jwvdvuurst/6502-board/6502-electrical-draft.csv

Reference | Qty | Value | DNP | Exclude from BOM | Exclude from Board | Exclude from Simulation | Exclude from Position Files | Footprint | Datasheet
C1 | 1 | 100nF - RESET_N power-on delay |  |  |  |  | ${EXCLUDE_FROM_POS_FILES} | Capacitor_THT:C_Disc_D5.0mm_W2.5mm_P5.00mm
C2,C3 | 2 | 27pF - crystal load |  |  |  |  | ${EXCLUDE_FROM_POS_FILES} | Capacitor_THT:C_Disc_D5.0mm_W2.5mm_P5.00mm
C4 | 1 | 100nF - U1 CPU |  |  |  |  | ${EXCLUDE_FROM_POS_FILES} | Capacitor_THT:C_Disc_D5.0mm_W2.5mm_P5.00mm
C5 | 1 | 100nF - U2 VIA |  |  |  |  | ${EXCLUDE_FROM_POS_FILES} | Capacitor_THT:C_Disc_D5.0mm_W2.5mm_P5.00mm
C6 | 1 | 100nF - U3 SRAM |  |  |  |  | ${EXCLUDE_FROM_POS_FILES} | Capacitor_THT:C_Disc_D5.0mm_W2.5mm_P5.00mm
C7 | 1 | 100nF - U4 address decoder |  |  |  |  | ${EXCLUDE_FROM_POS_FILES} | Capacitor_THT:C_Disc_D5.0mm_W2.5mm_P5.00mm
C8 | 1 | 100nF - U5 address mux |  |  |  |  | ${EXCLUDE_FROM_POS_FILES} | Capacitor_THT:C_Disc_D5.0mm_W2.5mm_P5.00mm
C9 | 1 | 100nF - U6 bank data mux |  |  |  |  | ${EXCLUDE_FROM_POS_FILES} | Capacitor_THT:C_Disc_D5.0mm_W2.5mm_P5.00mm
C10 | 1 | 100nF - U7 bank register |  |  |  |  | ${EXCLUDE_FROM_POS_FILES} | Capacitor_THT:C_Disc_D5.0mm_W2.5mm_P5.00mm
C11 | 1 | 100nF - U8 oscillator and inverters |  |  |  |  | ${EXCLUDE_FROM_POS_FILES} | Capacitor_THT:C_Disc_D5.0mm_W2.5mm_P5.00mm
C12 | 1 | 100nF - U9 I/O decoder |  |  |  |  | ${EXCLUDE_FROM_POS_FILES} | Capacitor_THT:C_Disc_D5.0mm_W2.5mm_P5.00mm
C13 | 1 | 100nF - U10 NAND logic |  |  |  |  | ${EXCLUDE_FROM_POS_FILES} | Capacitor_THT:C_Disc_D5.0mm_W2.5mm_P5.00mm
C14 | 1 | 100nF - U12 3-input NAND logic |  |  |  |  | ${EXCLUDE_FROM_POS_FILES} | Capacitor_THT:C_Disc_D5.0mm_W2.5mm_P5.00mm
C15 | 1 | 100nF - U15 NOR logic |  |  |  |  | ${EXCLUDE_FROM_POS_FILES} | Capacitor_THT:C_Disc_D5.0mm_W2.5mm_P5.00mm
C16 | 1 | 100nF - U16 3-input NOR logic |  |  |  |  | ${EXCLUDE_FROM_POS_FILES} | Capacitor_THT:C_Disc_D5.0mm_W2.5mm_P5.00mm
C17 | 1 | 100nF - U18 AND logic |  |  |  |  | ${EXCLUDE_FROM_POS_FILES} | Capacitor_THT:C_Disc_D5.0mm_W2.5mm_P5.00mm
C18 | 1 | 100nF - U19 bus transceiver |  |  |  |  | ${EXCLUDE_FROM_POS_FILES} | Capacitor_THT:C_Disc_D5.0mm_W2.5mm_P5.00mm
C19 | 1 | 100nF - U20 EPROM |  |  |  |  | ${EXCLUDE_FROM_POS_FILES} | Capacitor_THT:C_Disc_D5.0mm_W2.5mm_P5.00mm
C20 | 1 | 100nF - EPROM bypass |  |  |  |  | ${EXCLUDE_FROM_POS_FILES} | Capacitor_THT:C_Disc_D5.0mm_W2.5mm_P5.00mm
C21 | 1 | 10uF - 3V3 bulk bypass |  |  |  |  | ${EXCLUDE_FROM_POS_FILES} | Capacitor_THT:C_Disc_D5.0mm_W2.5mm_P5.00mm
J1 | 1 | REGULATED +3V3 INPUT - no regulator on board |  |  |  |  | ${EXCLUDE_FROM_POS_FILES} | Connector_PinHeader_2.54mm:PinHeader_1x02_P2.54mm_Vertical
J2 | 1 | Pico external harness - do not power Pico from this header |  |  |  |  | ${EXCLUDE_FROM_POS_FILES} | Connector_PinHeader_2.54mm:PinHeader_1x14_P2.54mm_Vertical
R1 | 1 | 1M - HCU04 crystal feedback |  |  |  |  | ${EXCLUDE_FROM_POS_FILES} | Resistor_THT:R_Axial_DIN0207_L6.3mm_D2.5mm_P7.62mm_Horizontal
R2 | 1 | 1k - crystal drive limiter |  |  |  |  | ${EXCLUDE_FROM_POS_FILES} | Resistor_THT:R_Axial_DIN0207_L6.3mm_D2.5mm_P7.62mm_Horizontal
R3 | 1 | 10k - RDY_N pull-up |  |  |  |  | ${EXCLUDE_FROM_POS_FILES} | Resistor_THT:R_Axial_DIN0207_L6.3mm_D2.5mm_P7.62mm_Horizontal
R4 | 1 | 10k - NMI_N pull-up |  |  |  |  | ${EXCLUDE_FROM_POS_FILES} | Resistor_THT:R_Axial_DIN0207_L6.3mm_D2.5mm_P7.62mm_Horizontal
R5 | 1 | 10k - BE pull-up |  |  |  |  | ${EXCLUDE_FROM_POS_FILES} | Resistor_THT:R_Axial_DIN0207_L6.3mm_D2.5mm_P7.62mm_Horizontal
R6 | 1 | 10k - SO_N pull-up |  |  |  |  | ${EXCLUDE_FROM_POS_FILES} | Resistor_THT:R_Axial_DIN0207_L6.3mm_D2.5mm_P7.62mm_Horizontal
R7 | 1 | 10k - RESET_N pull-up |  |  |  |  | ${EXCLUDE_FROM_POS_FILES} | Resistor_THT:R_Axial_DIN0207_L6.3mm_D2.5mm_P7.62mm_Horizontal
R8 | 1 | 10k - IRQ_N pull-up |  |  |  |  | ${EXCLUDE_FROM_POS_FILES} | Resistor_THT:R_Axial_DIN0207_L6.3mm_D2.5mm_P7.62mm_Horizontal
R9 | 1 | 10k - BUS_OE_N reset pull-up |  |  |  |  | ${EXCLUDE_FROM_POS_FILES} | Resistor_THT:R_Axial_DIN0207_L6.3mm_D2.5mm_P7.62mm_Horizontal
R10 | 1 | 10k - BUS_REQ reset pull-down |  |  |  |  | ${EXCLUDE_FROM_POS_FILES} | Resistor_THT:R_Axial_DIN0207_L6.3mm_D2.5mm_P7.62mm_Horizontal
R11 | 1 | 10k - BUS_DIR reset pull-down |  |  |  |  | ${EXCLUDE_FROM_POS_FILES} | Resistor_THT:R_Axial_DIN0207_L6.3mm_D2.5mm_P7.62mm_Horizontal
R12 | 1 | 10k - BUS_ACK idle pull-down |  |  |  |  | ${EXCLUDE_FROM_POS_FILES} | Resistor_THT:R_Axial_DIN0207_L6.3mm_D2.5mm_P7.62mm_Horizontal
SW1 | 1 | RESET |  |  |  |  | ${EXCLUDE_FROM_POS_FILES} | Button_Switch_THT:SW_PUSH_6mm
U1 | 1 | W65C02S6TPG-14 |  |  |  |  | ${EXCLUDE_FROM_POS_FILES} | Package_DIP:DIP-40_W15.24mm_Socket | https://www.westerndesigncenter.com/wdc/documentation/w65c02s.pdf
U2 | 1 | W65C22S6TPG-14 |  |  |  |  | ${EXCLUDE_FROM_POS_FILES} | Package_DIP:DIP-40_W15.24mm_Socket | https://www.westerndesigncenter.com/wdc/documentation/w65c22.pdf
U3 | 1 | AS6C4008 (512K x 8; use lower 256K) |  |  |  |  | ${EXCLUDE_FROM_POS_FILES} | Package_DIP:DIP-32_W15.24mm_Socket | https://www.alliancememory.com/wp-content/uploads/pdf/AS6C4008.pdf
U4 | 1 | 74HC138 |  |  |  |  | ${EXCLUDE_FROM_POS_FILES} | Package_DIP:DIP-16_W7.62mm_Socket | https://www.ti.com/lit/ds/symlink/sn74hc138.pdf
U5 | 1 | 74HC157 - SRAM address mux |  |  |  |  | ${EXCLUDE_FROM_POS_FILES} | Package_DIP:DIP-16_W7.62mm_Socket | https://www.ti.com/lit/ds/symlink/sn74hc157.pdf
U6 | 1 | 74HC157 - bank write data mux |  |  |  |  | ${EXCLUDE_FROM_POS_FILES} | Package_DIP:DIP-16_W7.62mm_Socket | https://www.ti.com/lit/ds/symlink/sn74hc157.pdf
U7 | 1 | 74HC273 - bank register |  |  |  |  | ${EXCLUDE_FROM_POS_FILES} | Package_DIP:DIP-20_W7.62mm_Socket | https://www.ti.com/lit/ds/symlink/sn74hc273.pdf
U8 | 1 | 74HCU04 |  |  |  |  | ${EXCLUDE_FROM_POS_FILES} | Package_DIP:DIP-14_W7.62mm_Socket | https://www.ti.com/lit/ds/symlink/sn74hcu04.pdf
U9 | 1 | 74HC138 - low-address I/O decode |  |  |  |  | ${EXCLUDE_FROM_POS_FILES} | Package_DIP:DIP-16_W7.62mm_Socket | https://www.ti.com/lit/ds/symlink/sn74hc138.pdf
U10 | 1 | 74HC00 |  |  |  |  | ${EXCLUDE_FROM_POS_FILES} | Package_DIP:DIP-14_W7.62mm_Socket | https://www.ti.com/lit/ds/symlink/sn74hc00.pdf
U12 | 1 | 74HC10 |  |  |  |  | ${EXCLUDE_FROM_POS_FILES} | Package_DIP:DIP-14_W7.62mm_Socket | https://www.ti.com/lit/ds/symlink/sn74hc10.pdf
U15 | 1 | 74HC02 |  |  |  |  | ${EXCLUDE_FROM_POS_FILES} | Package_DIP:DIP-14_W7.62mm_Socket | https://www.ti.com/lit/ds/symlink/sn74hc02.pdf
U16 | 1 | 74HC27 |  |  |  |  | ${EXCLUDE_FROM_POS_FILES} | Package_DIP:DIP-14_W7.62mm_Socket | https://www.ti.com/lit/ds/symlink/sn74hc27.pdf
U18 | 1 | 74HC08 |  |  |  |  | ${EXCLUDE_FROM_POS_FILES} | Package_DIP:DIP-14_W7.62mm_Socket | https://www.ti.com/lit/ds/symlink/sn74hc08.pdf
U19 | 1 | SN74HC245N - Pico/VIA bus transceiver |  |  |  |  | ${EXCLUDE_FROM_POS_FILES} | Package_DIP:DIP-20_W7.62mm_Socket | https://www.ti.com/lit/ds/symlink/sn74hc245.pdf
U20 | 1 | AT27LV256A 3.3V OTP EPROM - legacy DIP variant; verify sourcing |  |  |  |  | ${EXCLUDE_FROM_POS_FILES} | Package_DIP:DIP-28_W15.24mm_Socket | https://ww1.microchip.com/downloads/en/DeviceDoc/doc0601.pdf
Y1 | 1 | 1.000MHz fundamental, CL=16pF |  |  |  |  | ${EXCLUDE_FROM_POS_FILES} | Crystal:Crystal_HC49-U_Vertical
