jwvdvuurst/6502-board/6502-board-architecture.pdf

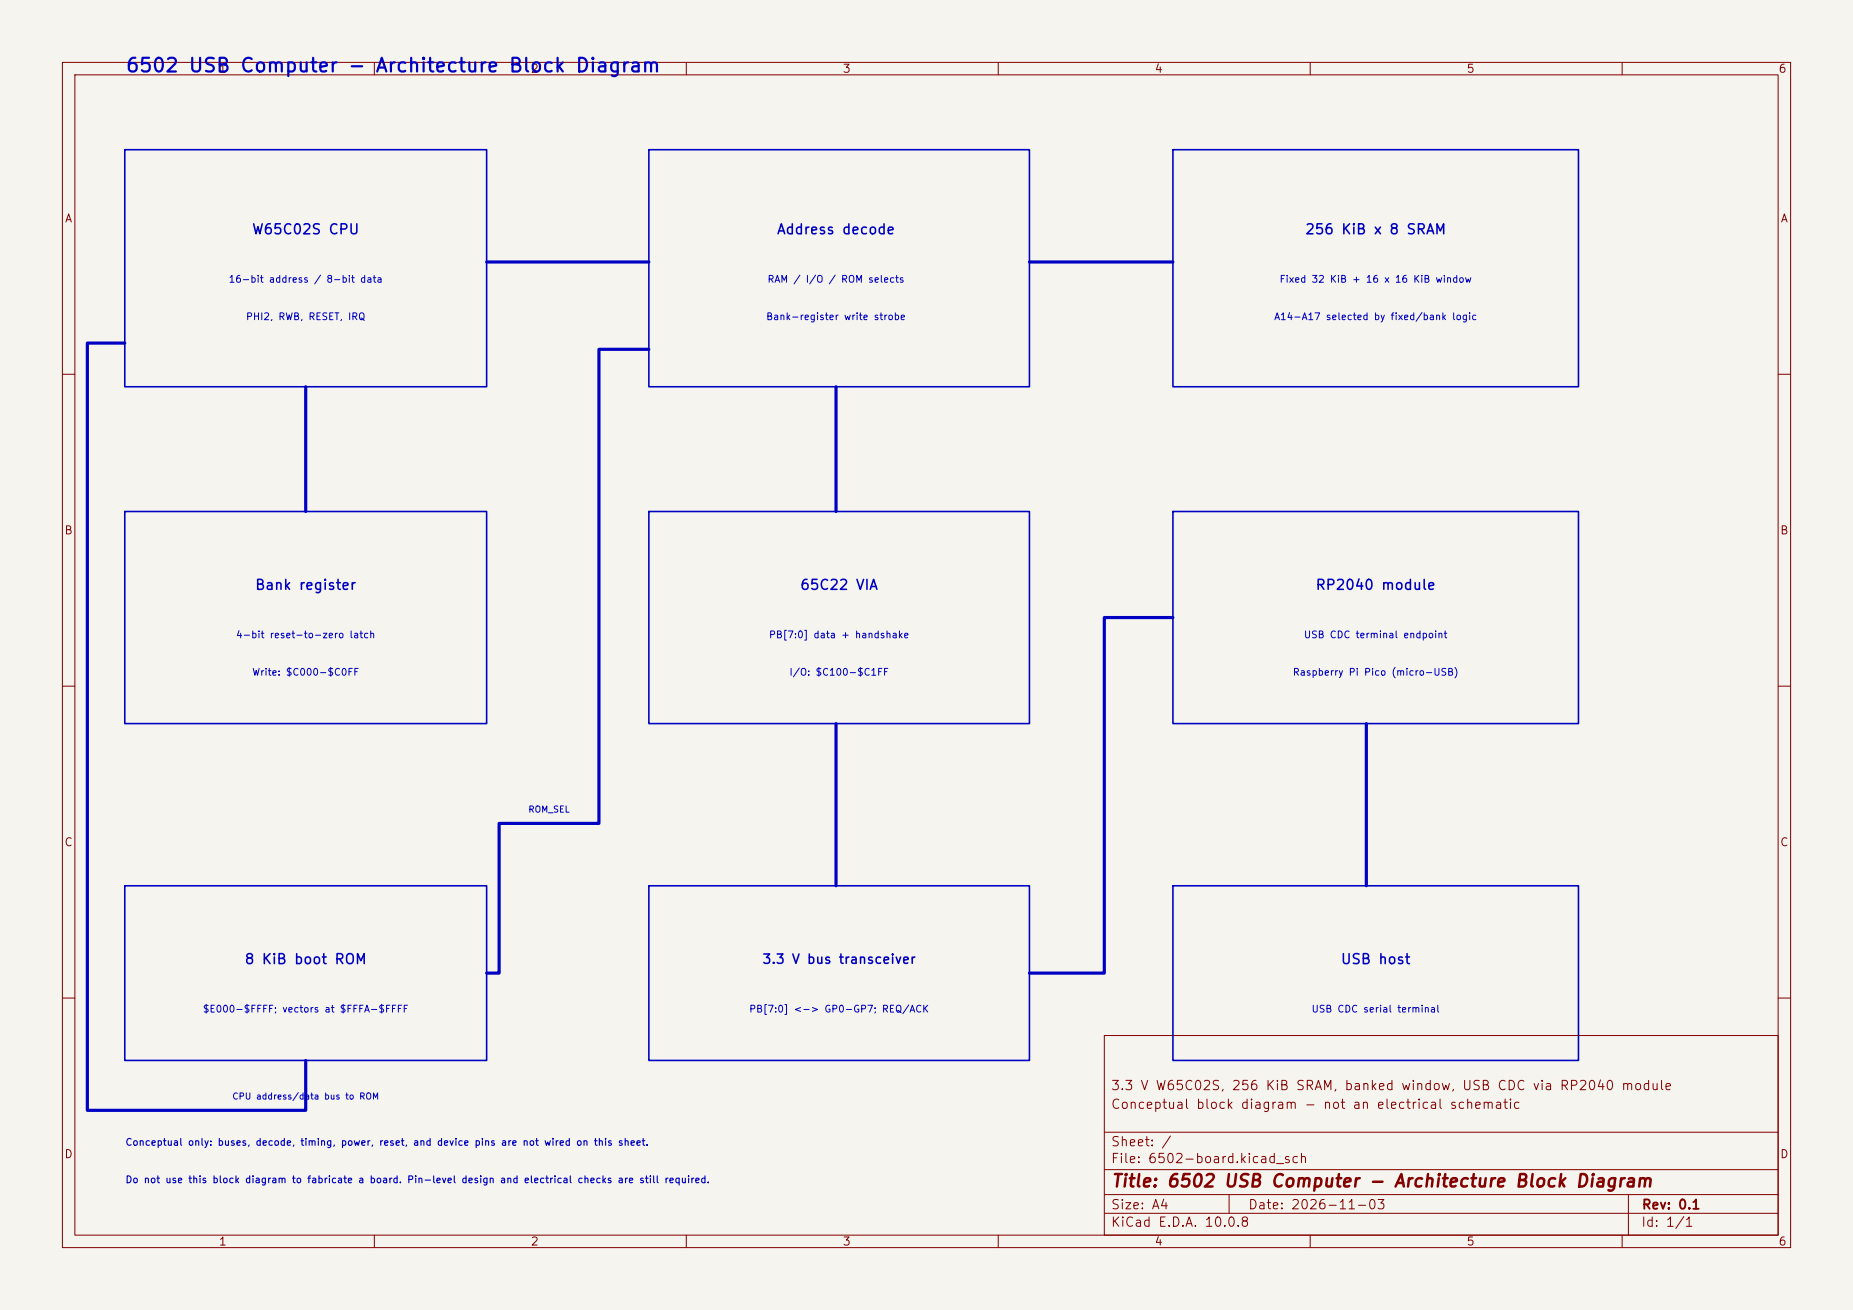
[picture p1: page 1]

16-bit address / 8-bit data

A14-A17 selected by fixed/bank logic

Raspberry Pi Pico (micro-USB)

$E000-$FFFF; vectors at $FFFA-$FFFF CPU address/data bus to ROM

3.3 V W65C02S, 256 KiB SRAM, banked window, USB CDC via RP2040 module
Conceptual block diagram - not an electrical schematic

Conceptual only: buses, decode, timing, power, reset, and device pins are not wired on this sheet.

Sheet: /
File: 6502-board.kicad_sch
Title: 6502 USB Computer - Architecture Block Diagram

Do not use this block diagram to fabricate a board. Pin-level design and electrical checks are still required.

Size: A4 | Rev: 0.1
KiCad E.D.A. 10.0.8 | Id: 1/1
