jwvdvuurst/6502-board/6502-electrical-draft.kicad_pcb

## KiCad design 6502-electrical-draft.kicad_pcb (2026-11-06)

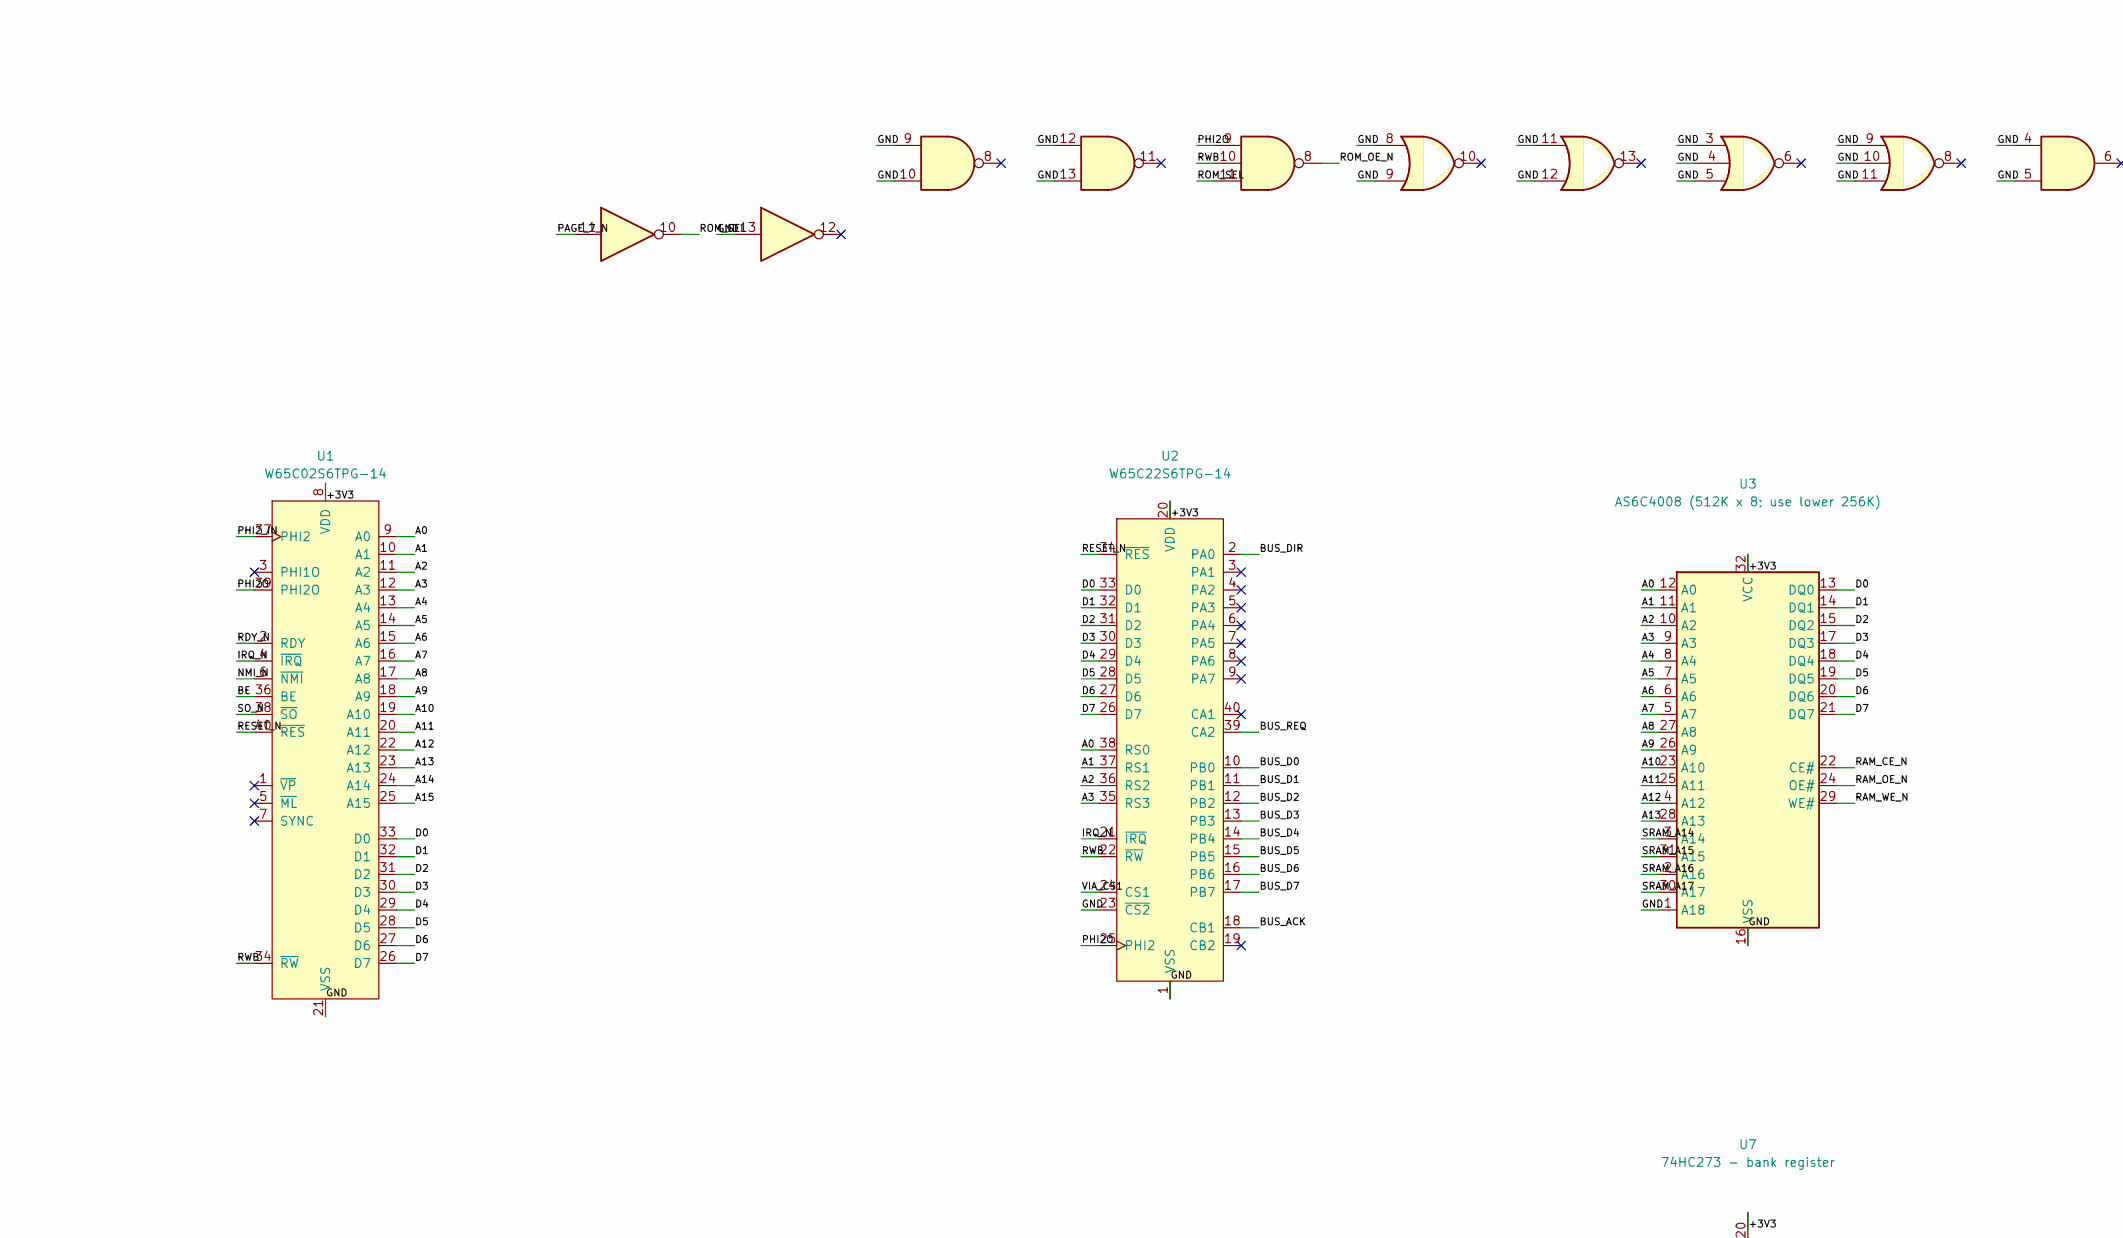
[picture p3: schematic 6502-electrical-draft.kicad_sch, 6502 Electrical Draft - CPU, VIA, SRAM and EPROM, part in row 1, column 1]

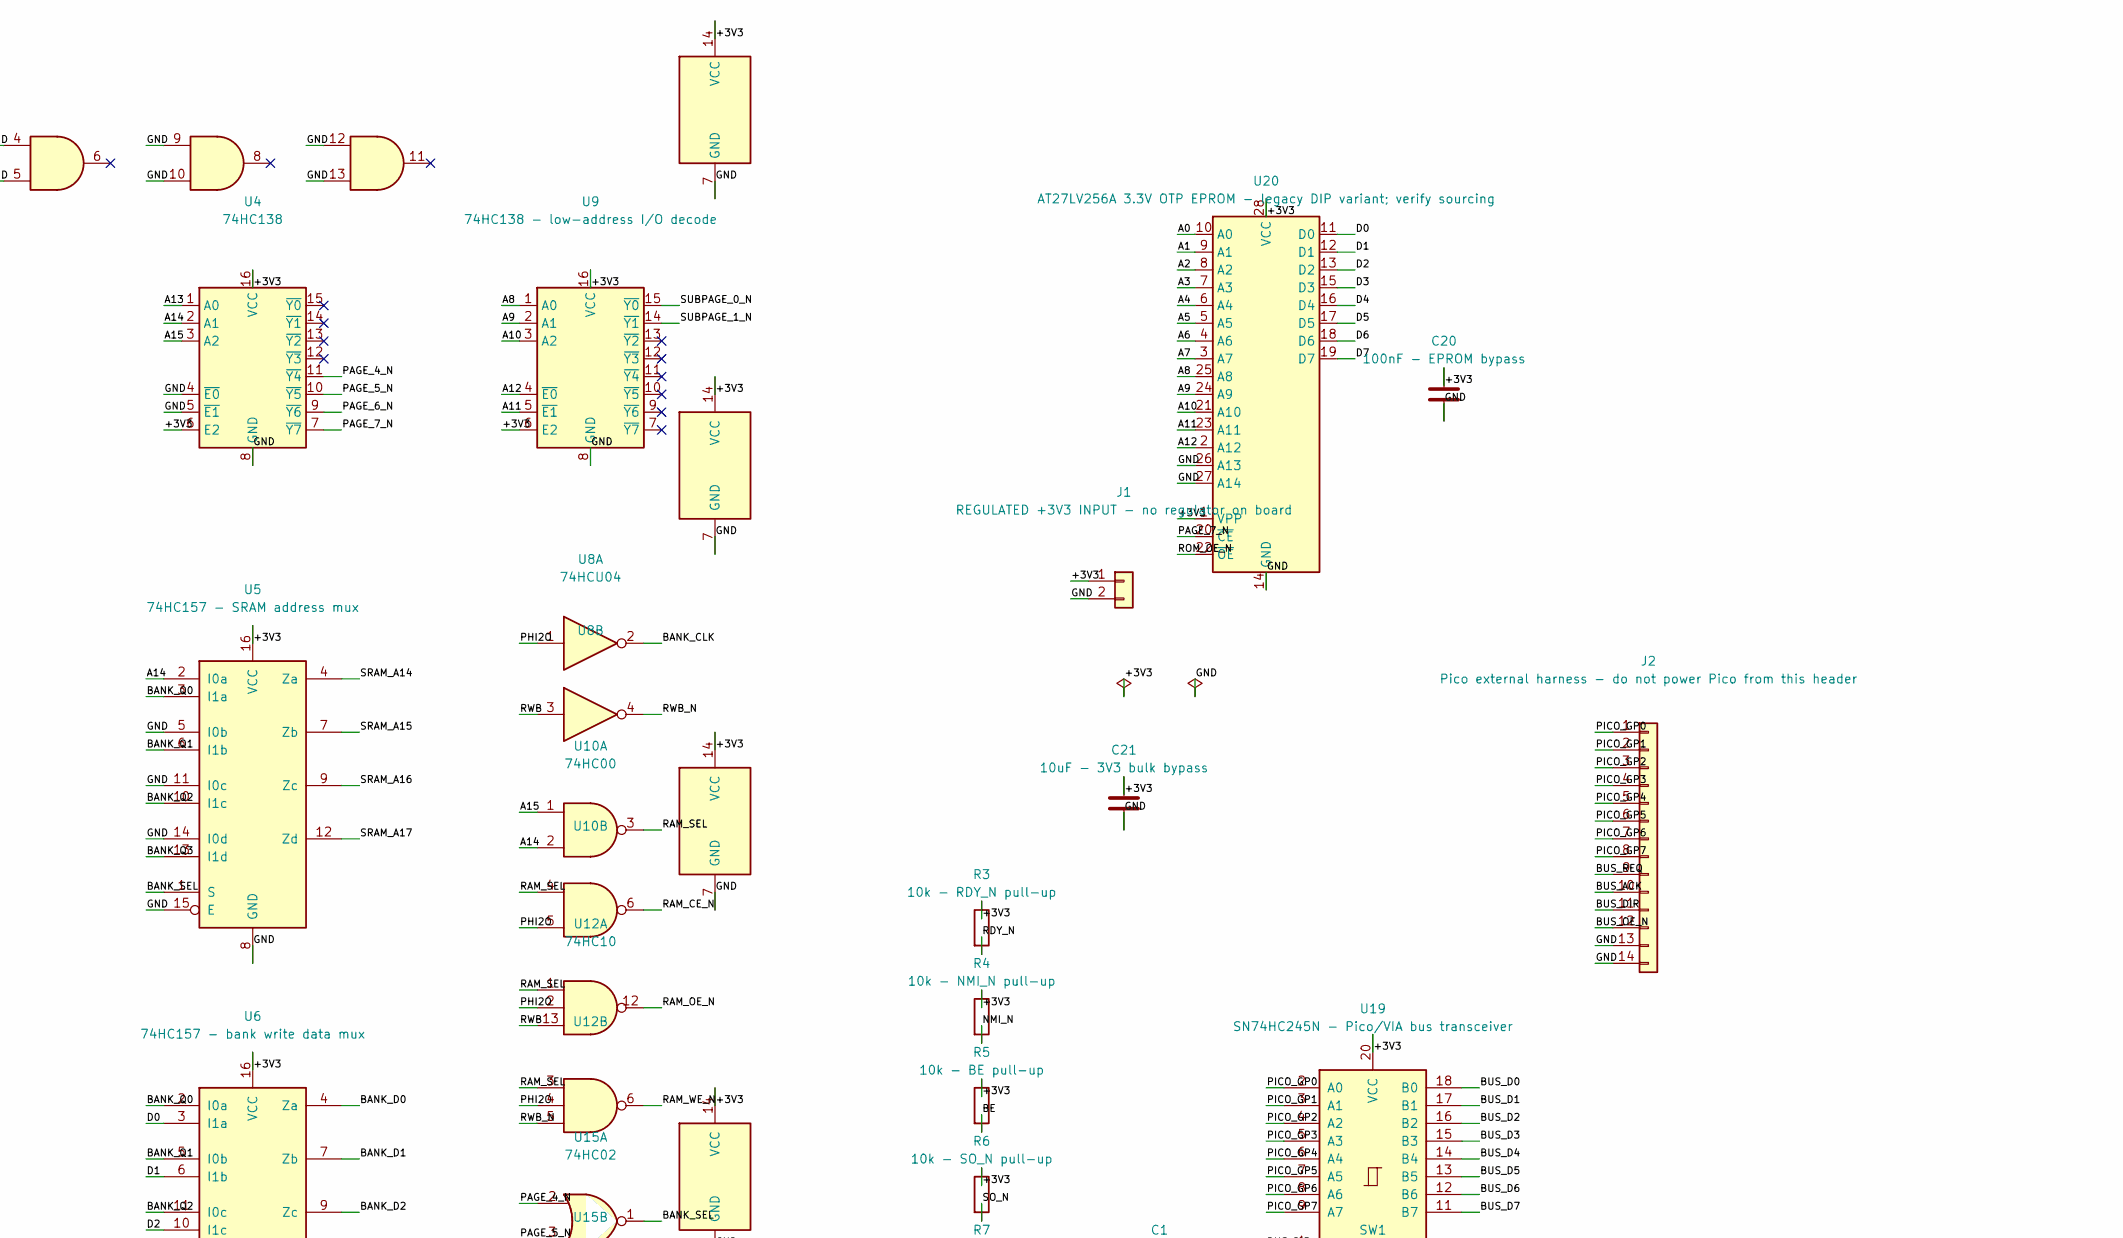
[picture p4: schematic 6502-electrical-draft.kicad_sch, 6502 Electrical Draft - CPU, VIA, SRAM and EPROM, part in row 1, column 2]

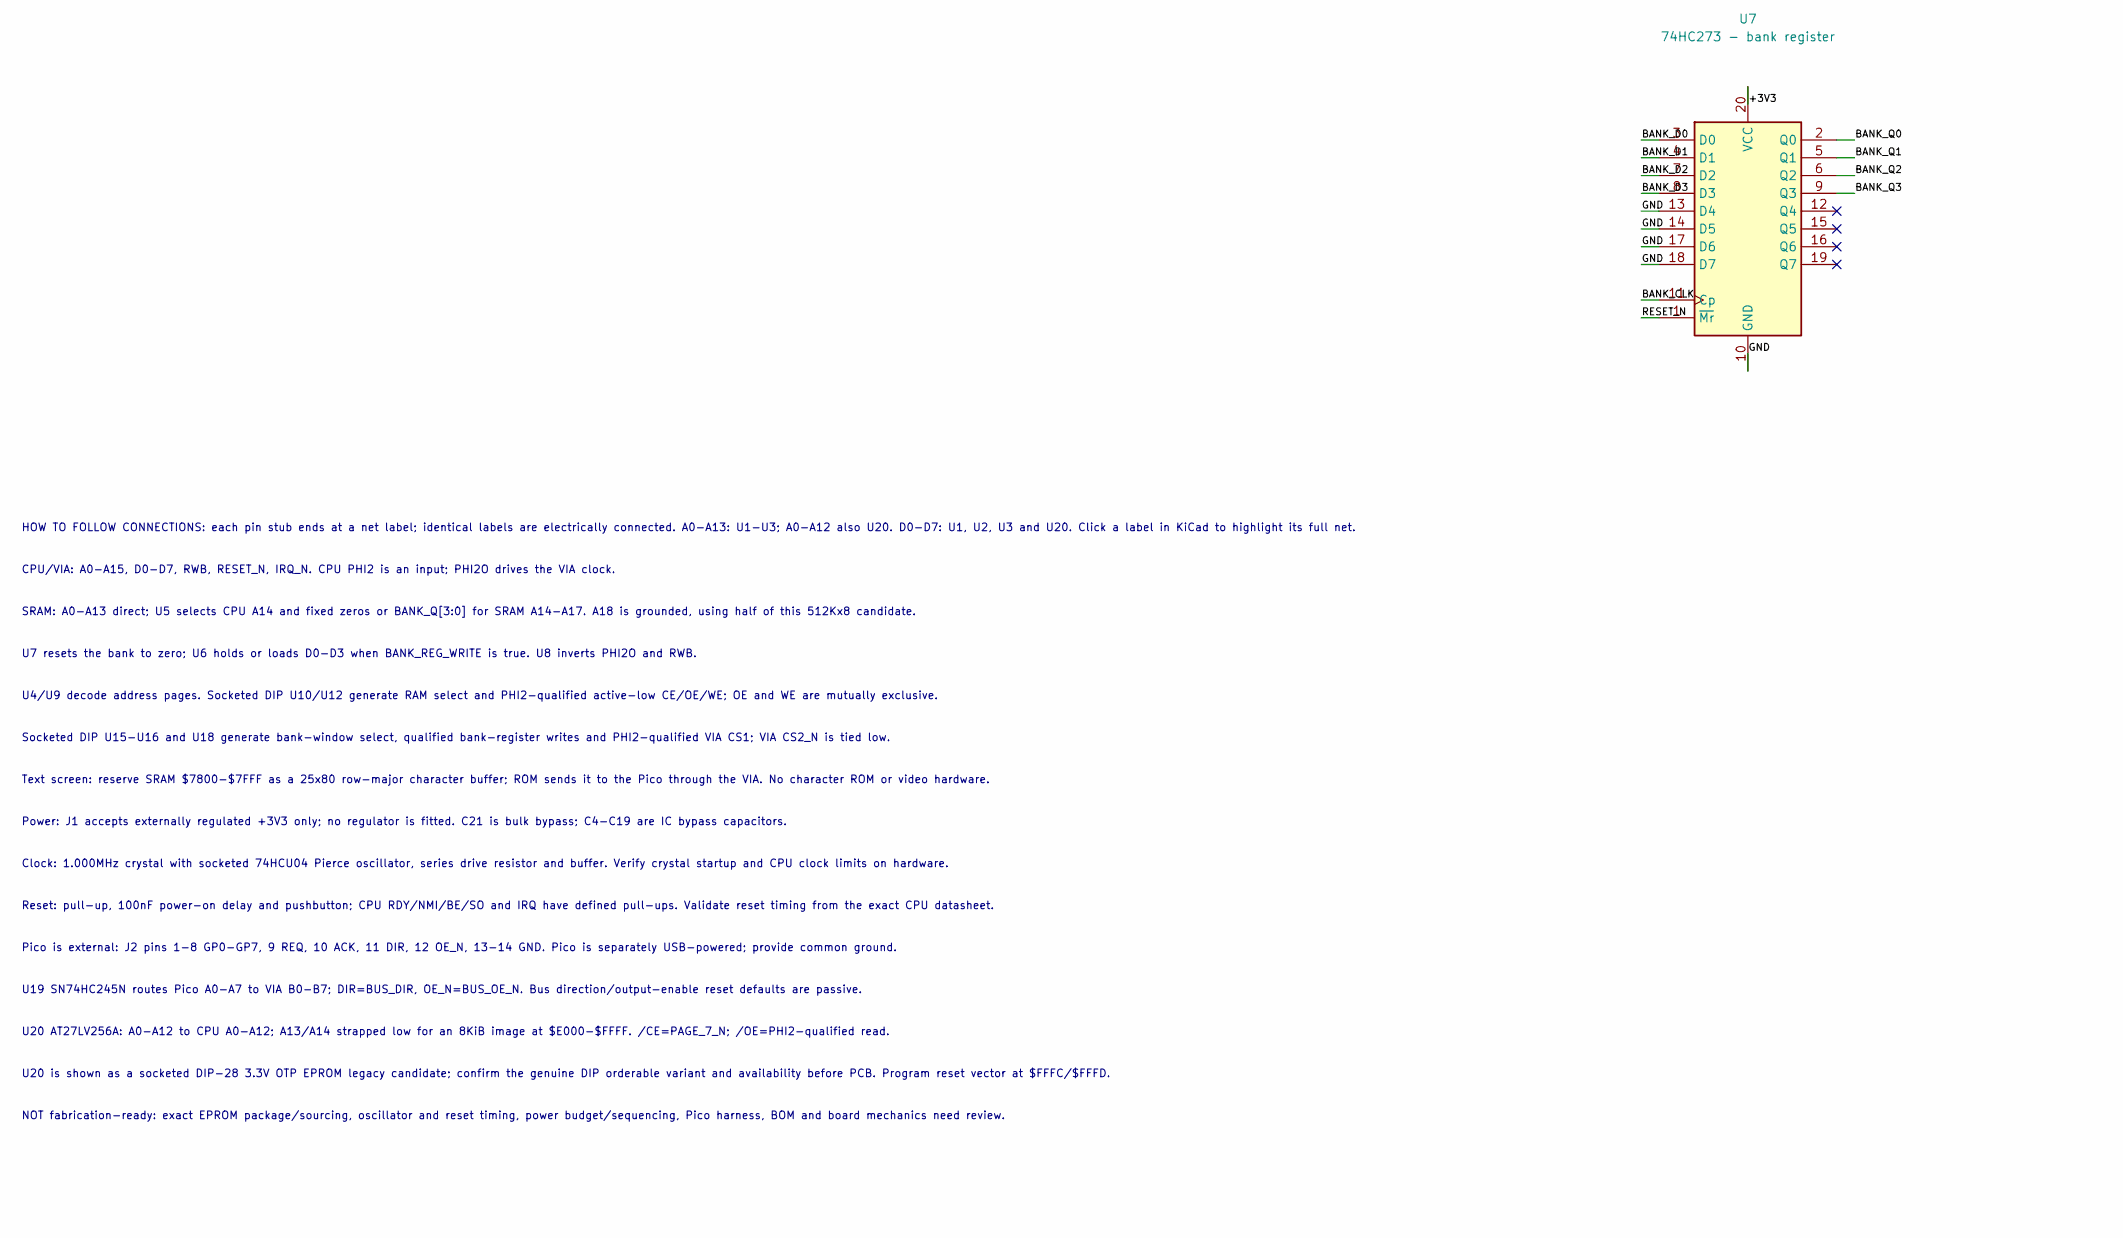
[picture p5: schematic 6502-electrical-draft.kicad_sch, 6502 Electrical Draft - CPU, VIA, SRAM and EPROM, part in row 2, column 1]

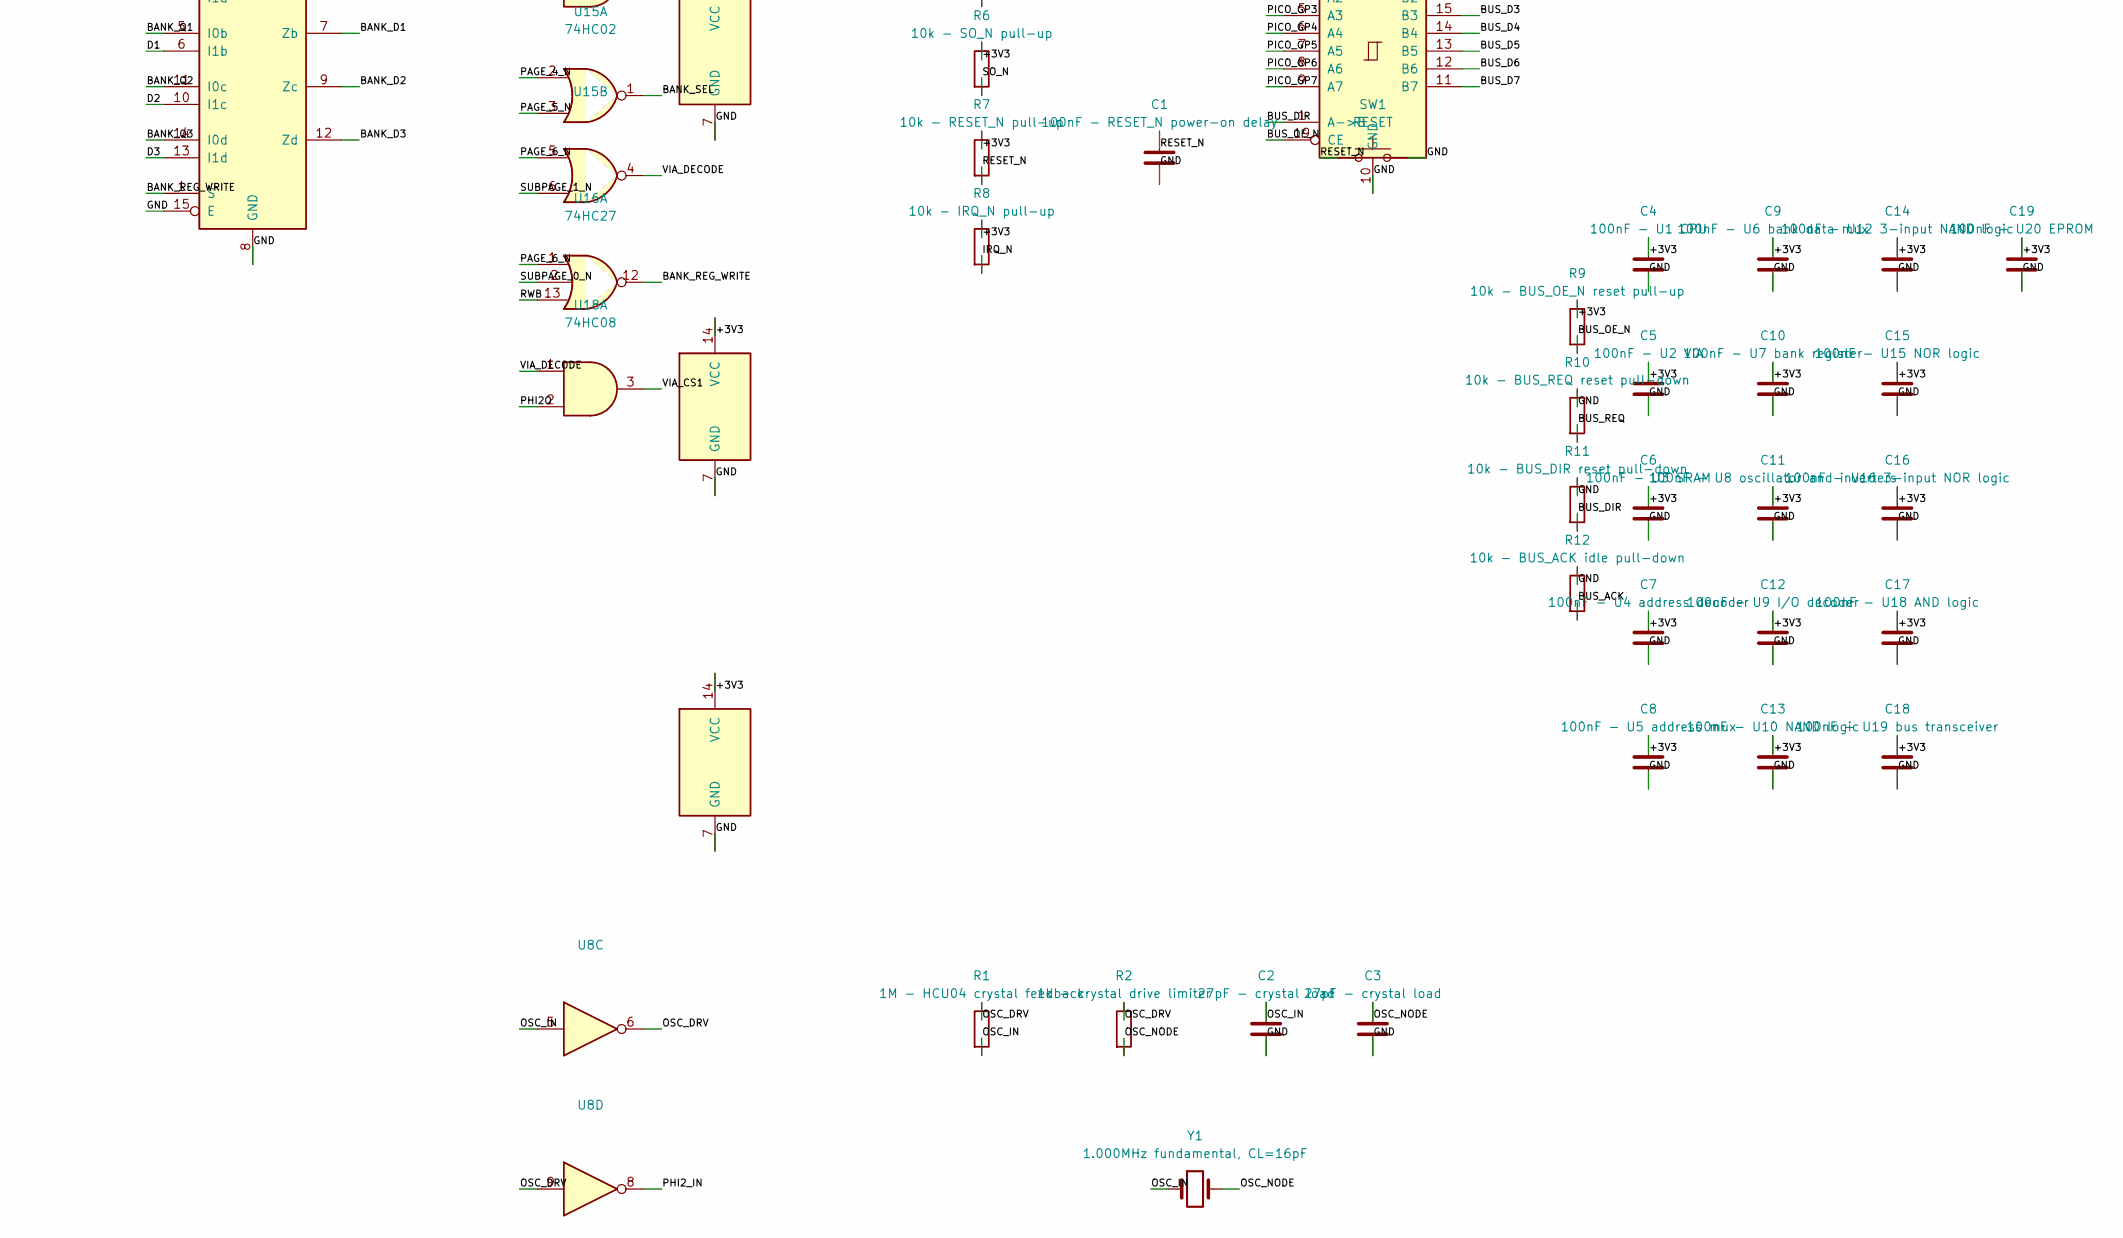
[picture p6: schematic 6502-electrical-draft.kicad_sch, 6502 Electrical Draft - CPU, VIA, SRAM and EPROM, part in row 2, column 2]

Parts:
C1: 100nF - RESET_N power-on delay; C_Disc_D5.0mm_W2.5mm_P5.00mm
C2, C3: 27pF - crystal load; C_Disc_D5.0mm_W2.5mm_P5.00mm
C4: 100nF - U1 CPU; C_Disc_D5.0mm_W2.5mm_P5.00mm
C5: 100nF - U2 VIA; C_Disc_D5.0mm_W2.5mm_P5.00mm
C6: 100nF - U3 SRAM; C_Disc_D5.0mm_W2.5mm_P5.00mm
C7: 100nF - U4 address decoder; C_Disc_D5.0mm_W2.5mm_P5.00mm
C8: 100nF - U5 address mux; C_Disc_D5.0mm_W2.5mm_P5.00mm
C9: 100nF - U6 bank data mux; C_Disc_D5.0mm_W2.5mm_P5.00mm
C10: 100nF - U7 bank register; C_Disc_D5.0mm_W2.5mm_P5.00mm
C11: 100nF - U8 oscillator and inverters; C_Disc_D5.0mm_W2.5mm_P5.00mm
C12: 100nF - U9 I/O decoder; C_Disc_D5.0mm_W2.5mm_P5.00mm
C13: 100nF - U10 NAND logic; C_Disc_D5.0mm_W2.5mm_P5.00mm
C14: 100nF - U12 3-input NAND logic; C_Disc_D5.0mm_W2.5mm_P5.00mm
C15: 100nF - U15 NOR logic; C_Disc_D5.0mm_W2.5mm_P5.00mm
C16: 100nF - U16 3-input NOR logic; C_Disc_D5.0mm_W2.5mm_P5.00mm
C17: 100nF - U18 AND logic; C_Disc_D5.0mm_W2.5mm_P5.00mm
C18: 100nF - U19 bus transceiver; C_Disc_D5.0mm_W2.5mm_P5.00mm
C19: 100nF - U20 EPROM; C_Disc_D5.0mm_W2.5mm_P5.00mm
C20: 100nF - EPROM bypass; C_Disc_D5.0mm_W2.5mm_P5.00mm
C21: 10uF - 3V3 bulk bypass; C_Disc_D5.0mm_W2.5mm_P5.00mm
J1: REGULATED +3V3 INPUT - no regulator on board; PinHeader_1x02_P2.54mm_Vertical
J2: Pico external harness - do not power Pico from th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; PinHeader_1x14_P2.54mm_Vertical
R1: 1M - HCU04 crystal feedback; R_Axial_DIN0207_L6.3mm_D2.5mm_P7.62mm_Horizontal
R2: 1k - crystal drive limiter; R_Axial_DIN0207_L6.3mm_D2.5mm_P7.62mm_Horizontal
R3: 10k - RDY_N pull-up; R_Axial_DIN0207_L6.3mm_D2.5mm_P7.62mm_Horizontal
R4: 10k - NMI_N pull-up; R_Axial_DIN0207_L6.3mm_D2.5mm_P7.62mm_Horizontal
R5: 10k - BE pull-up; R_Axial_DIN0207_L6.3mm_D2.5mm_P7.62mm_Horizontal
R6: 10k - SO_N pull-up; R_Axial_DIN0207_L6.3mm_D2.5mm_P7.62mm_Horizontal
R7: 10k - RESET_N pull-up; R_Axial_DIN0207_L6.3mm_D2.5mm_P7.62mm_Horizontal
R8: 10k - IRQ_N pull-up; R_Axial_DIN0207_L6.3mm_D2.5mm_P7.62mm_Horizontal
R9: 10k - BUS_OE_N reset pull-up; R_Axial_DIN0207_L6.3mm_D2.5mm_P7.62mm_Horizontal
R10: 10k - BUS_REQ reset pull-down; R_Axial_DIN0207_L6.3mm_D2.5mm_P7.62mm_Horizontal
R11: 10k - BUS_DIR reset pull-down; R_Axial_DIN0207_L6.3mm_D2.5mm_P7.62mm_Horizontal
R12: 10k - BUS_ACK idle pull-down; R_Axial_DIN0207_L6.3mm_D2.5mm_P7.62mm_Horizontal
SW1: RESET; SW_PUSH_6mm
U1: W65C02S6TPG-14; DIP-40_W15.24mm_Socket
U2: W65C22S6TPG-14; DIP-40_W15.24mm_Socket
U3: AS6C4008 (512K x 8; use lower 256K); DIP-32_W15.24mm_Socket
U4: 74HC138; DIP-16_W7.62mm_Socket
U5: 74HC157 - SRAM address mux; DIP-16_W7.62mm_Socket
U6: 74HC157 - bank write data mux; DIP-16_W7.62mm_Socket
U7: 74HC273 - bank register; DIP-20_W7.62mm_Socket
U8: 74HCU04; DIP-14_W7.62mm_Socket
U9: 74HC138 - low-address I/O decode; DIP-16_W7.62mm_Socket
U10: 74HC00; DIP-14_W7.62mm_Socket
U12: 74HC10; DIP-14_W7.62mm_Socket
U15: 74HC02; DIP-14_W7.62mm_Socket
U16: 74HC27; DIP-14_W7.62mm_Socket
U18: 74HC08; DIP-14_W7.62mm_Socket
U19: SN74HC245N - Pico/VIA bus transceiver; DIP-20_W7.62mm_Socket
U20: AT27LV256A 3.3V OTP EPROM - legacy DIP variant; v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; DIP-28_W15.24mm_Socket
Y1: 1.000MHz fundamental, CL=16pF; Crystal_HC49-U_Vertical

Connections:
/+3V3: C4.1, C5.1, C6.1, C7.1, C8.1, C9.1, C10.1, C11.1, C12.1, C13.1, C14.1, C15.1, C16.1, C17.1, C18.1, C19.1, C20.1, C21.1, J1.1, R3.1, R4.1, R5.1, R6.1, R7.1, R8.1, R9.1, U1.8 (VDD), U2.20 (VDD), U3.32 (VCC), U4.6 (E2), U4.16 (VCC), U5.16 (VCC), U6.16 (VCC), U7.20 (VCC), U8.14 (VCC), U9.6 (E2), U9.16 (VCC), U10.14 (VCC), U12.14 (VCC), U15.14 (VCC), U16.14 (VCC), U18.14 (VCC), U19.20 (VCC), U20.1 (VPP), U20.28 (VCC)
/A0: U1.9 (A0), U2.38 (RS0), U3.12 (A0), U20.10 (A0)
/A1: U1.10 (A1), U2.37 (RS1), U3.11 (A1), U20.9 (A1)
/A2: U1.11 (A2), U2.36 (RS2), U3.10 (A2), U20.8 (A2)
/A3: U1.12 (A3), U2.35 (RS3), U3.9 (A3), U20.7 (A3)
/A4: U1.13 (A4), U3.8 (A4), U20.6 (A4)
/A5: U1.14 (A5), U3.7 (A5), U20.5 (A5)
/A6: U1.15 (A6), U3.6 (A6), U20.4 (A6)
/A7: U1.16 (A7), U3.5 (A7), U20.3 (A7)
/A8: U1.17 (A8), U3.27 (A8), U9.1 (A0), U20.25 (A8)
/A9: U1.18 (A9), U3.26 (A9), U9.2 (A1), U20.24 (A9)
/A10: U1.19 (A10), U3.23 (A10), U9.3 (A2), U20.21 (A10)
/A11: U1.20 (A11), U3.25 (A11), U9.5 (~E1), U20.23 (A11)
/A12: U1.22 (A12), U3.4 (A12), U9.4 (~E0), U20.2 (A12)
/A13: U1.23 (A13), U3.28 (A13), U4.1 (A0)
/A14: U1.24 (A14), U4.2 (A1), U5.2 (I0a), U10.2
/A15: U1.25 (A15), U4.3 (A2), U10.1
/BANK_CLK: U7.11 (Cp), U8.2
/BANK_D0: U6.4 (Za), U7.3 (D0)
/BANK_D1: U6.7 (Zb), U7.4 (D1)
/BANK_D2: U6.9 (Zc), U7.7 (D2)
/BANK_D3: U6.12 (Zd), U7.8 (D3)
/BANK_Q0: U5.3 (I1a), U6.2 (I0a), U7.2 (Q0)
/BANK_Q1: U5.6 (I1b), U6.5 (I0b), U7.5 (Q1)
/BANK_Q2: U5.10 (I1c), U6.11 (I0c), U7.6 (Q2)
/BANK_Q3: U5.13 (I1d), U6.14 (I0d), U7.9 (Q3)
/BANK_REG_WRITE: U6.1 (S), U16.12
/BANK_SEL: U5.1 (S), U15.1
/BE: R5.2, U1.36 (BE)
/BUS_ACK: J2.10, R12.2, U2.18 (CB1)
/BUS_D0: U2.10 (PB0), U19.18 (B0)
/BUS_D1: U2.11 (PB1), U19.17 (B1)
/BUS_D2: U2.12 (PB2), U19.16 (B2)
/BUS_D3: U2.13 (PB3), U19.15 (B3)
/BUS_D4: U2.14 (PB4), U19.14 (B4)
/BUS_D5: U2.15 (PB5), U19.13 (B5)
/BUS_D6: U2.16 (PB6), U19.12 (B6)
/BUS_D7: U2.17 (PB7), U19.11 (B7)
/BUS_DIR: J2.11, R11.2, U2.2 (PA0), U19.1 (A->B)
/BUS_OE_N: J2.12, R9.2, U19.19 (CE)
/BUS_REQ: J2.9, R10.2, U2.39 (CA2)
/D0: U1.33 (D0), U2.33 (D0), U3.13 (DQ0), U6.3 (I1a), U20.11 (D0)
/D1: U1.32 (D1), U2.32 (D1), U3.14 (DQ1), U6.6 (I1b), U20.12 (D1)
/D2: U1.31 (D2), U2.31 (D2), U3.15 (DQ2), U6.10 (I1c), U20.13 (D2)
/D3: U1.30 (D3), U2.30 (D3), U3.17 (DQ3), U6.13 (I1d), U20.15 (D3)
/D4: U1.29 (D4), U2.29 (D4), U3.18 (DQ4), U20.16 (D4)
/D5: U1.28 (D5), U2.28 (D5), U3.19 (DQ5), U20.17 (D5)
/D6: U1.27 (D6), U2.27 (D6), U3.20 (DQ6), U20.18 (D6)
/D7: U1.26 (D7), U2.26 (D7), U3.21 (DQ7), U20.19 (D7)
/GND: C1.2, C2.2, C3.2, C4.2, C5.2, C6.2, C7.2, C8.2, C9.2, C10.2, C11.2, C12.2, C13.2, C14.2, C15.2, C16.2, C17.2, C18.2, C19.2, C20.2, C21.2, J1.2, J2.13, J2.14, R10.1, R11.1, R12.1, SW1.2, U1.21 (VSS), U2.1 (VSS), U2.23 (~CS2), U3.1 (A18), U3.16 (VSS), U4.4 (~E0), U4.5 (~E1), U4.8 (GND), U5.5 (I0b), U5.8 (GND), U5.11 (I0c), U5.14 (I0d), U5.15 (E), U6.8 (GND), U6.15 (E), U7.10 (GND), U7.13 (D4), U7.14 (D5), U7.17 (D6), U7.18 (D7), U8.7 (GND), U8.13, U9.8 (GND), U10.7 (GND), U10.9, U10.10, U10.12, U10.13, U12.7 (GND), U15.7 (GND), U15.8, U15.9, U15.11, U15.12, U16.3, U16.4, U16.5, U16.7 (GND), U16.9, U16.10, U16.11, U18.4, U18.5, U18.7 (GND), U18.9, U18.10, U18.12, U18.13, U19.10 (GND), U20.14 (GND), U20.26 (A13), U20.27 (A14)
/IRQ_N: R8.2, U1.4 (~IRQ), U2.21 (~IRQ)
/NMI_N: R4.2, U1.6 (~NMI)
/OSC_DRV: R1.1, R2.1, U8.6, U8.9
/OSC_IN: C2.1, R1.2, U8.5, Y1.1
/OSC_NODE: C3.1, R2.2, Y1.2
/PAGE_4_N: U4.11 (~Y4), U15.2
/PAGE_5_N: U4.10 (~Y5), U15.3
/PAGE_6_N: U4.9 (~Y6), U15.5, U16.1
/PAGE_7_N: U4.7 (~Y7), U8.11, U20.20 (~CE)
/PHI2O: U1.39 (PHI2O), U2.25 (PHI2), U8.1, U10.5, U12.2, U12.4, U12.9, U18.2
/PHI2_IN: U1.37 (PHI2), U8.8
/PICO_GP0: J2.1, U19.2 (A0)
/PICO_GP1: J2.2, U19.3 (A1)
/PICO_GP2: J2.3, U19.4 (A2)
/PICO_GP3: J2.4, U19.5 (A3)
/PICO_GP4: J2.5, U19.6 (A4)
/PICO_GP5: J2.6, U19.7 (A5)
/PICO_GP6: J2.7, U19.8 (A6)
/PICO_GP7: J2.8, U19.9 (A7)
/RAM_CE_N: U3.22 (CE#), U10.6
/RAM_OE_N: U3.24 (OE#), U12.12
/RAM_SEL: U10.3, U10.4, U12.1, U12.3
/RAM_WE_N: U3.29 (WE#), U12.6
/RDY_N: R3.2, U1.2 (RDY)
/RESET_N: C1.1, R7.2, SW1.1, U1.40 (~RES), U2.34 (~RES), U7.1 (~Mr)
/ROM_OE_N: U12.8, U20.22 (~OE)
/ROM_SEL: U8.10, U12.11
/RWB: U1.34 (~RW), U2.22 (~RW), U8.3, U12.10, U12.13, U16.13
/RWB_N: U8.4, U12.5
/SO_N: R6.2, U1.38 (~SO)
/SRAM_A14: U3.3 (A14), U5.4 (Za)
/SRAM_A15: U3.31 (A15), U5.7 (Zb)
/SRAM_A16: U3.2 (A16), U5.9 (Zc)
/SRAM_A17: U3.30 (A17), U5.12 (Zd)
/SUBPAGE_0_N: U9.15 (~Y0), U16.2
/SUBPAGE_1_N: U9.14 (~Y1), U15.6
/VIA_CS1: U2.24 (CS1), U18.3
/VIA_DECODE: U15.4, U18.1

Notes on the sheet:
HOW TO FOLLOW CONNECTIONS: each pin stub ends at a net label; identical labels are electrically connected. A0-A13: U1-U3; A0-A12 also U20. D0-D7: U1, U2, U3 and U20. Click a label in KiCad to highlight its full net.
CPU/VIA: A0-A15, D0-D7, RWB, RESET_N, IRQ_N. CPU PHI2 is an input; PHI2O drives the VIA clock.
SRAM: A0-A13 direct; U5 selects CPU A14 and fixed zeros or BANK_Q[3:0] for SRAM A14-A17. A18 is grounded, using half of this 512Kx8 candidate.
U7 resets the bank to zero; U6 holds or loads D0-D3 when BANK_REG_WRITE is true. U8 inverts PHI2O and RWB.
U4/U9 decode address pages. Socketed DIP U10/U12 generate RAM select and PHI2-qualified active-low CE/OE/WE; OE and WE are mutually exclusive.
Socketed DIP U15-U16 and U18 generate bank-window select, qualified bank-register writes and PHI2-qualified VIA CS1; VIA CS2_N is tied low.
Text screen: reserve SRAM $7800-$7FFF as a 25x80 row-major character buffer; ROM sends it to the Pico through the VIA. No character ROM or video hardware.
Power: J1 accepts externally regulated +3V3 only; no regulator is fitted. C21 is bulk bypass; C4-C19 are IC bypass capacitors.
Clock: 1.000MHz crystal with socketed 74HCU04 Pierce oscillator, series drive resistor and buffer. Verify crystal startup and CPU clock limits on hardware.
Reset: pull-up, 100nF power-on delay and pushbutton; CPU RDY/NMI/BE/SO and IRQ have defined pull-ups. Validate reset timing from the exact CPU datasheet.
Pico is external: J2 pins 1-8 GP0-GP7, 9 REQ, 10 ACK, 11 DIR, 12 OE_N, 13-14 GND. Pico is separately USB-powered; provide common ground.
U19 SN74HC245N routes Pico A0-A7 to VIA B0-B7; DIR=BUS_DIR, OE_N=BUS_OE_N. Bus direction/output-enable reset defaults are passive.
U20 AT27LV256A: A0-A12 to CPU A0-A12; A13/A14 strapped low for an 8KiB image at $E000-$FFFF. /CE=PAGE_7_N; /OE=PHI2-qualified read.
U20 is shown as a socketed DIP-28 3.3V OTP EPROM legacy candidate; confirm the genuine DIP orderable variant and availability before PCB. Program reset vector at $FFFC/$FFFD.
NOT fabrication-ready: exact EPROM package/sourcing, oscillator and reset timing, power budget/sequencing, Pico harness, BOM and board mechanics need review.

Board: 2 copper layers, 53 parts (0 on the bottom side), 88 nets, no tracks yet.
