jwvdvuurst/6502-board/pico/tusb_config.h

/**
 * SPDX-License-Identifier: GPL-3.0-only
 * @file tusb_config.h
 * TinyUSB compile-time configuration. Macro names are fixed by TinyUSB.
 */
#ifndef BOARD_TUSB_CONFIG_H
#define BOARD_TUSB_CONFIG_H
#ifndef CFG_TUSB_MCU
#define CFG_TUSB_MCU OPT_MCU_RP2040
#endif
#ifndef CFG_TUSB_OS
#define CFG_TUSB_OS OPT_OS_NONE
#endif
#define CFG_TUSB_RHPORT0_MODE (OPT_MODE_DEVICE | OPT_MODE_FULL_SPEED)
#define CFG_TUD_ENABLED 1
#define CFG_TUD_ENDPOINT0_SIZE 64
/// Expose only a single CDC port; disable unrelated USB classes.
#define CFG_TUD_CDC 1
#define CFG_TUD_MSC 0
#define CFG_TUD_HID 0
#define CFG_TUD_MIDI 0
#define CFG_TUD_VENDOR 0
/// Endpoint FIFOs complement the bridge keyboard queue and apply USB backpressure.
#define CFG_TUD_CDC_RX_BUFSIZE 512
#define CFG_TUD_CDC_TX_BUFSIZE 512
#define CFG_TUD_CDC_EP_BUFSIZE 64
#endif
