jwvdvuurst/6502-board/(commit log)

2026-11-05 Add 6502 board design and ROM firmware
    [6502-board.kicad_sch, 6502-electrical-draft.csv, 6502-electrical-draft.kicad_sch, ram.cfg, rom.cfg]
2026-11-06 Implement portable protocol logic for 6502 terminal
    - Add bridge.c and bridge.h for handling display decoding, keyboard buffering, and GPIO state management.
    - Introduce main.c to manage GPIO adapter and USB service loop.
    - Implement terminal.c and terminal.h for incremental ANSI rendering and USB output management.
    - Create tests in test_bridge.c to validate display framing, keyboard queue, and bus operations.
    - Add TinyUSB configuration in tusb_config.h and USB descriptors in usb_descriptors.c for CDC console support.
    - Implement build script build.ps1 for project setup and testing.
    [6502-electrical-draft.csv, 6502-electrical-draft.kicad_pcb, 6502-electrical-draft.kicad_sch]
